Kananyan2311/Rubble-Rover/docsu/dcc4e0d6-4336-4faa-92a5-f5ddd7daa5ca.jpg

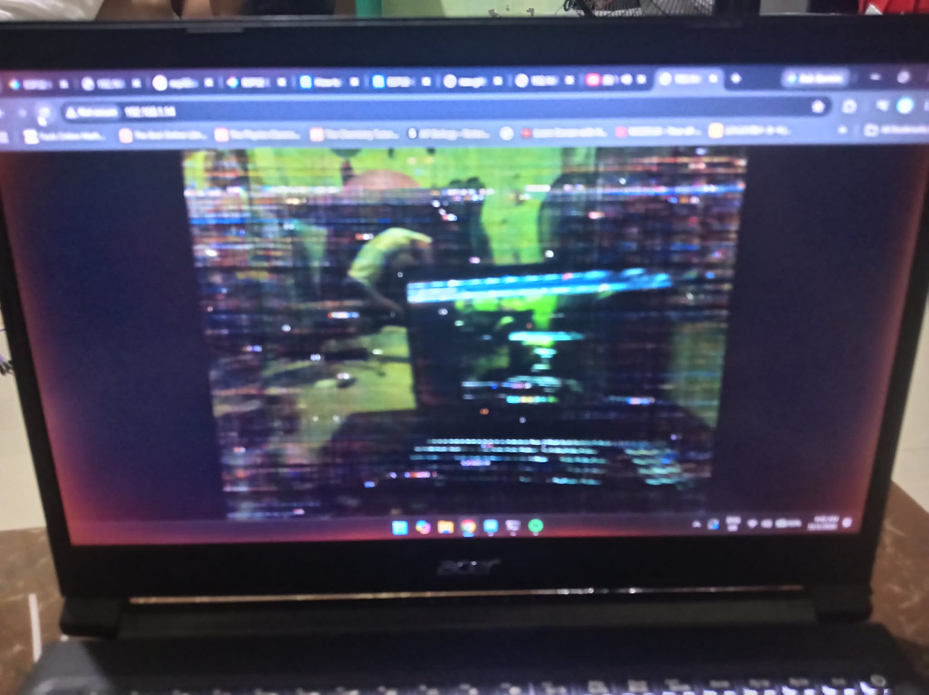
docsu/dcc4e0d6-4336-4faa-92a5-f5ddd7daa5ca.jpg
