Kananyan2311/Rubble-Rover/docsu/97220a8d-4763-489b-a496-95a2f28a7e50.jpg

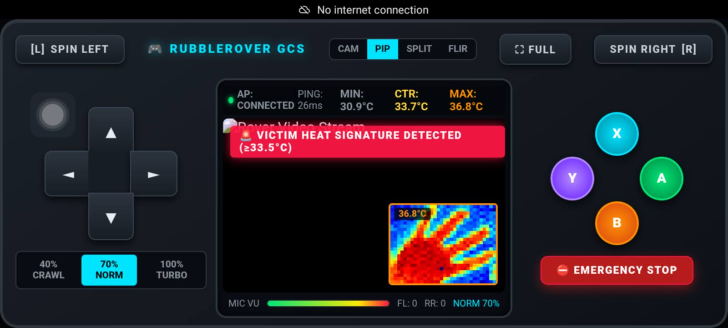
docsu/97220a8d-4763-489b-a496-95a2f28a7e50.jpg
