Kananyan2311/Rubble-Rover/docsu/8ca135fd-bad1-460d-b041-587a1cfcafc5.jpg

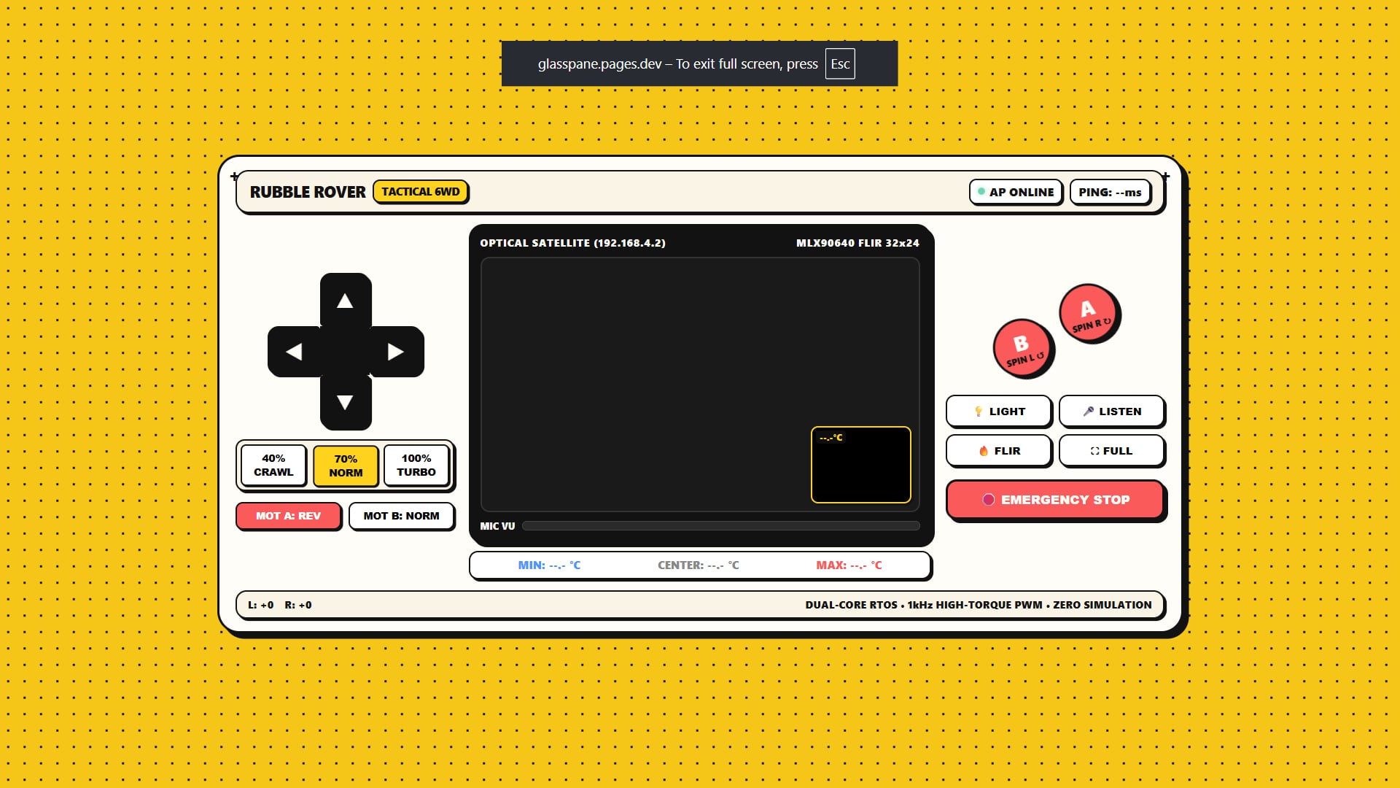
docsu/8ca135fd-bad1-460d-b041-587a1cfcafc5.jpg
