Kananyan2311/Rubble-Rover/docsu/85fc39a5-d4aa-493a-b52b-8984eef353a9.jpg

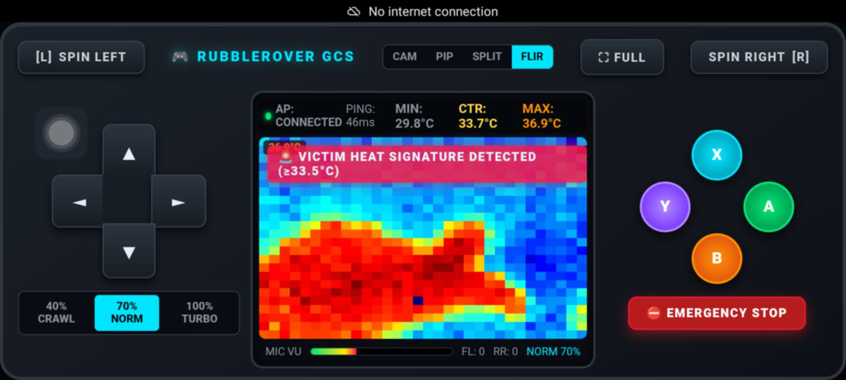
docsu/85fc39a5-d4aa-493a-b52b-8984eef353a9.jpg
