Kananyan2311/Rubble-Rover/docsu/70634dc6-3c7f-4a7d-961d-5ee7b60996f9.jpg

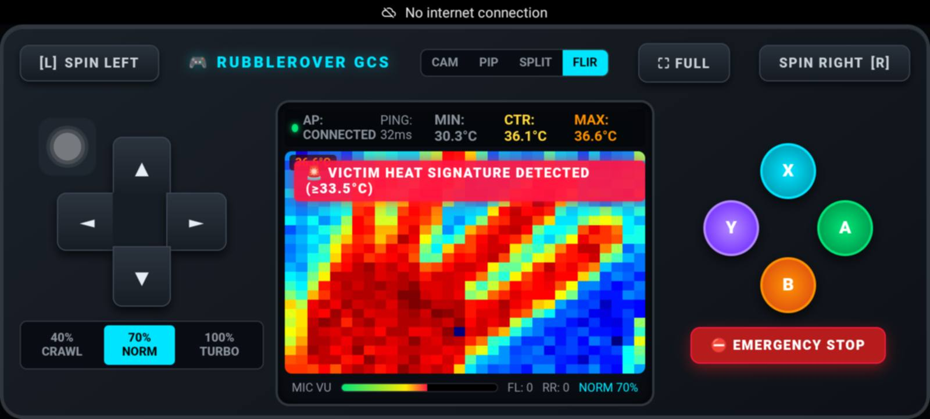
docsu/70634dc6-3c7f-4a7d-961d-5ee7b60996f9.jpg
