Kananyan2311/Rubble-Rover/docsu/801663b0-5177-4fae-9b44-58f6171b3113.jpg

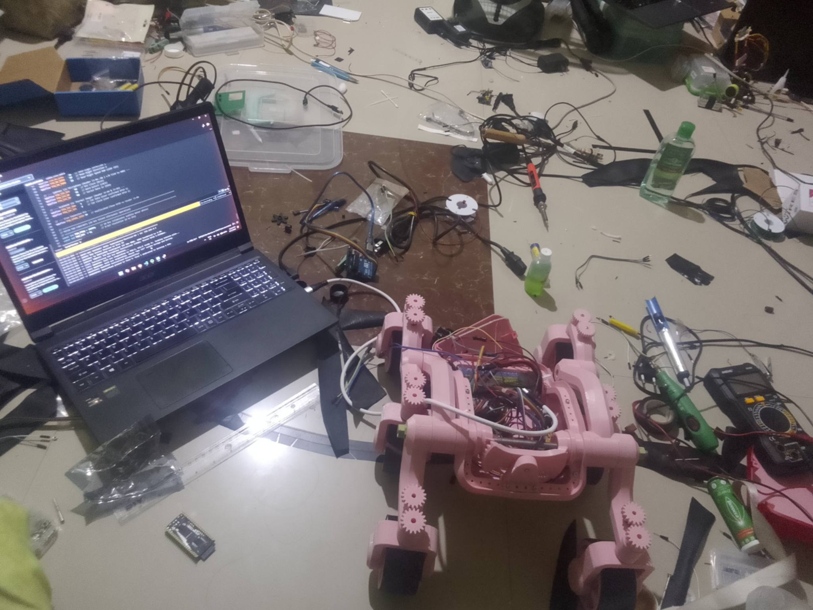
docsu/801663b0-5177-4fae-9b44-58f6171b3113.jpg
