Kananyan2311/Rubble-Rover/docsu/ec8b5fc5-6190-4d5c-a91b-74c8f4051346.jpg

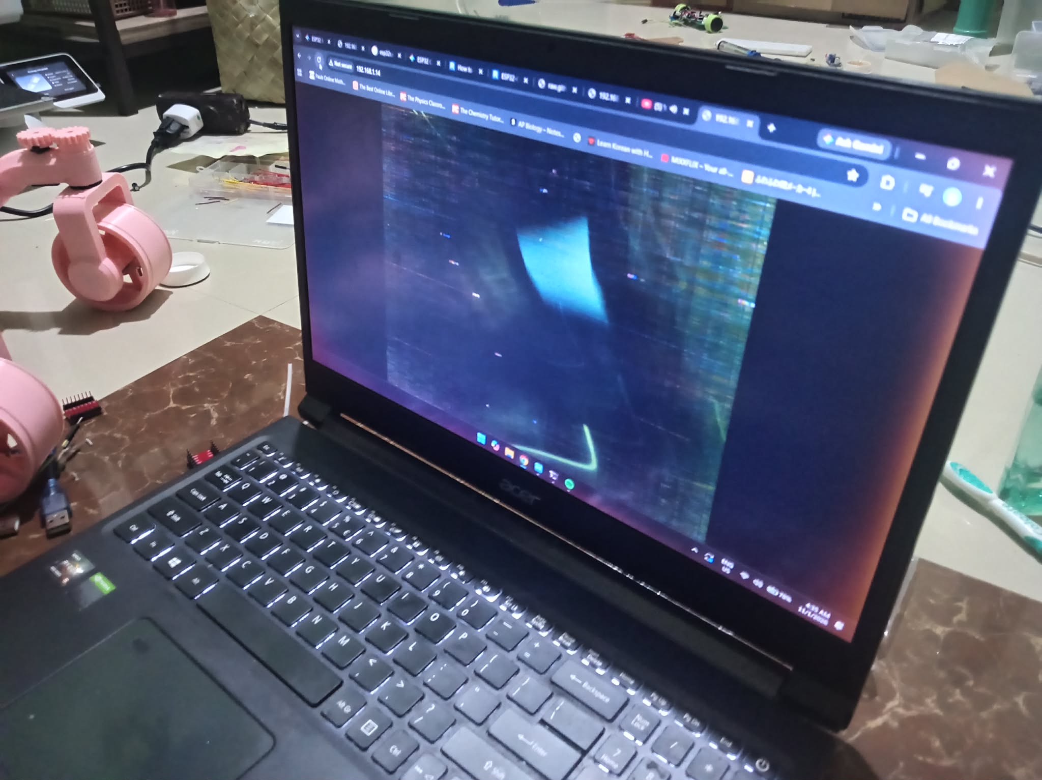
docsu/ec8b5fc5-6190-4d5c-a91b-74c8f4051346.jpg
