Kananyan2311/Rubble-Rover/docsu/f98f0c3a-2285-47ac-bcab-6023abbcfe9a.jpg

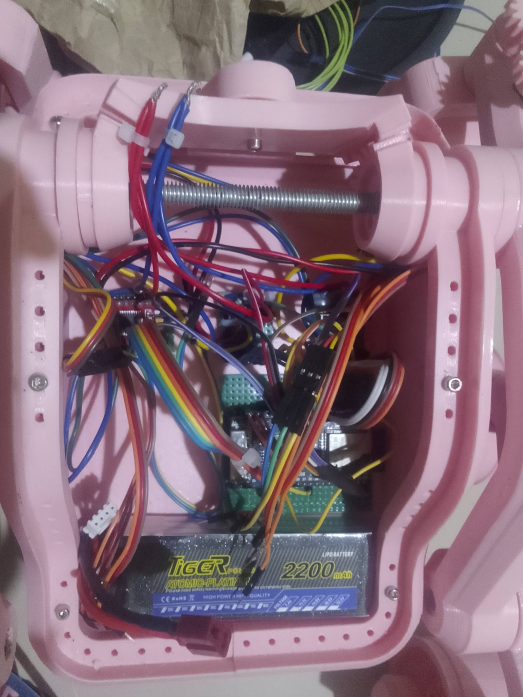
docsu/f98f0c3a-2285-47ac-bcab-6023abbcfe9a.jpg
