Kananyan2311/Rubble-Rover/ESP32_S3_ROVER_PINOUT.csv

Pin_Number | Header | ESP32_GPIO | Signal_Net_Name | Connected_Device | Device_Pin | Signal_Type | Description
J1-01 | J1 | 3V3 | 3V3_LOGIC | TB6612_#1_#2_#3 | VCC_AND_STBY | POWER | 3.3V Logic & STBY Hardwired (Always Active)
J1-02 | J1 | 3V3 | 3V3_SPARE | NC | NC | POWER | Spare 3.3V
J1-03 | J1 | EN | MCU_EN | RESET_BTN | EN | INPUT | Reset Pull-up
J1-04 | J1 | GPIO4 | M_ML_PWMA | TB6612_#2 | PWMA | OUTPUT_PWM | Middle-Left Motor Speed PWM (LEDC Ch2)
J1-05 | J1 | GPIO5 | M_ML_AIN1 | TB6612_#2 | AIN1 | OUTPUT_DIG | Middle-Left Motor Direction 1
J1-06 | J1 | GPIO6 | M_ML_AIN2 | TB6612_#2 | AIN2 | OUTPUT_DIG | Middle-Left Motor Direction 2
J1-07 | J1 | GPIO7 | M_MR_BIN1 | TB6612_#2 | BIN1 | OUTPUT_DIG | Middle-Right Motor Direction 1
J1-08 | J1 | GPIO15 | M_MR_BIN2 | TB6612_#2 | BIN2 | OUTPUT_DIG | Middle-Right Motor Direction 2
J1-09 | J1 | GPIO16 | M_MR_PWMB | TB6612_#2 | PWMB | OUTPUT_PWM | Middle-Right Motor Speed PWM (LEDC Ch3)
J1-10 | J1 | GPIO17 | M_FL_PWMA | TB6612_#1 | PWMA | OUTPUT_PWM | Front-Left Motor Speed PWM (LEDC Ch0)
J1-11 | J1 | GPIO18 | M_FL_AIN1 | TB6612_#1 | AIN1 | OUTPUT_DIG | Front-Left Motor Direction 1
J1-12 | J1 | GPIO8 | M_FL_AIN2 | TB6612_#1 | AIN2 | OUTPUT_DIG | Front-Left Motor Direction 2
J1-13 | J1 | GPIO3 | NC_STRAP | NC | NC | STRAPPING_PIN | JTAG Strap - DO NOT CONNECT (LEAVE NC)!
J1-14 | J1 | GPIO46 | NC_STRAP | NC | NC | STRAPPING_PIN | ROM Boot Log Strap - DO NOT CONNECT (LEAVE NC)!
J1-15 | J1 | GPIO9 | M_FR_BIN1 | TB6612_#1 | BIN1 | OUTPUT_DIG | Front-Right Motor Direction 1
J1-16 | J1 | GPIO10 | M_FR_BIN2 | TB6612_#1 | BIN2 | OUTPUT_DIG | Front-Right Motor Direction 2
J1-17 | J1 | GPIO11 | M_FR_PWMB | TB6612_#1 | PWMB | OUTPUT_PWM | Front-Right Motor Speed PWM (LEDC Ch1)
J1-18 | J1 | GPIO12 | M_RL_PWMA | TB6612_#3 | PWMA | OUTPUT_PWM | Rear-Left Motor Speed PWM (LEDC Ch4)
J1-19 | J1 | GPIO13 | M_RL_AIN1 | TB6612_#3 | AIN1 | OUTPUT_DIG | Rear-Left Motor Direction 1
J1-20 | J1 | GPIO14 | M_RL_AIN2 | TB6612_#3 | AIN2 | OUTPUT_DIG | Rear-Left Motor Direction 2
J1-21 | J1 | 5V | 5V_MCU | BUCK_CONV | 5V_OUT | POWER | 5V Main Supply Input to ESP32-S3 from Buck Converter
J1-22 | J1 | GND | GND | SYSTEM_GND | GND | POWER | Digital Ground Plane
J3-01 | J3 | GND | GND | SYSTEM_GND | GND | POWER | Digital Ground Plane
J3-02 | J3 | GPIO43 | UART0_TXD | DEBUG_HEADER | TXD | OUTPUT_DIG | UART0 Serial Debug TX - Keep Free
J3-03 | J3 | GPIO44 | UART0_RXD | DEBUG_HEADER | RXD | INPUT_DIG | UART0 Serial Debug RX - Keep Free
J3-04 | J3 | GPIO1 | I2C_THERMAL_SCL | MLX90640 | SCL | OUTPUT_DIG | MLX90640 I2C Clock (with 4.7k Pull-up)
J3-05 | J3 | GPIO2 | I2C_THERMAL_SDA | MLX90640 | SDA | BIDIRECTIONAL | MLX90640 I2C Data (with 4.7k Pull-up)
J3-06 | J3 | GPIO42 | I2S_MIC_SCK | INMP441 | SCK | OUTPUT_DIG | INMP441 I2S Bit Clock (BCLK) [Contiguous Bus]
J3-07 | J3 | GPIO41 | I2S_MIC_WS | INMP441 | WS | OUTPUT_DIG | INMP441 I2S Word Select (LRCK) [Contiguous Bus]
J3-08 | J3 | GPIO40 | I2S_MIC_SD | INMP441 | SD | INPUT_DIG | INMP441 I2S Serial Data Out (DIN) [Contiguous Bus]
J3-09 | J3 | GPIO39 | SPARE_IO39 | AUX_HEADER | SPARE | BIDIRECTIONAL | Clean Expansion GPIO (Unused / Spare)
J3-10 | J3 | GPIO38 | M_RR_BIN1 | TB6612_#3 | BIN1 | OUTPUT_DIG | Rear-Right Motor Direction 1
J3-11 | J3 | GPIO37 | NC_PSRAM | NC | NC | OCTAL_PSRAM | Octal PSRAM Line - DO NOT CONNECT (LEAVE NC)!
J3-12 | J3 | GPIO36 | NC_PSRAM | NC | NC | OCTAL_PSRAM | Octal PSRAM Line - DO NOT CONNECT (LEAVE NC)!
J3-13 | J3 | GPIO35 | NC_PSRAM | NC | NC | OCTAL_PSRAM | Octal PSRAM Line - DO NOT CONNECT (LEAVE NC)!
J3-14 | J3 | GPIO0 | NC_STRAP | NC | NC | STRAPPING_PIN | Boot Mode Strap / Button - DO NOT CONNECT (LEAVE NC)!
J3-15 | J3 | GPIO45 | NC_STRAP | NC | NC | STRAPPING_PIN | VDD_SPI Strap - DO NOT CONNECT (LEAVE NC)!
J3-16 | J3 | GPIO48 | NC_WS2812 | NC | NC | RGB_LED | DevKitC v1.0 Onboard WS2812 DIN - LEAVE UNCONNECTED (NC)
J3-17 | J3 | GPIO47 | M_RR_BIN2 | TB6612_#3 | BIN2 | OUTPUT_DIG | Rear-Right Motor Direction 2
J3-18 | J3 | GPIO21 | M_RR_PWMB | TB6612_#3 | PWMB | OUTPUT_PWM | Rear-Right Motor Speed PWM (LEDC Ch5)
J3-19 | J3 | GPIO20 | USB_DP | USB_HEADER | D+ | USB | Native USB D+ - Keep Free
J3-20 | J3 | GPIO19 | USB_DM | USB_HEADER | D- | USB | Native USB D- - Keep Free
J3-21 | J3 | GND | GND | SYSTEM_GND | GND | POWER | Digital Ground Plane
J3-22 | J3 | GND | GND | SYSTEM_GND | GND | POWER | Digital Ground Plane
CAM-01 | CAM_P1 | 5V | 5V_CAM | BUCK_CONV | 5V_OUT | POWER | 5V Main Supply Input to ESP32-CAM
CAM-02 | CAM_P1 | GND | GND | SYSTEM_GND | GND | POWER | Common Ground
CAM-03 | CAM_P1 | GPIO12 | NC_CAM | NC | NC | NC | Free - Leave Unconnected
CAM-04 | CAM_P1 | GPIO13 | NC_CAM | NC | NC | NC | Free - Leave Unconnected
CAM-05 | CAM_P1 | GPIO15 | NC_CAM | NC | NC | NC | Free - Leave Unconnected
CAM-06 | CAM_P1 | GPIO14 | NC_CAM | NC | NC | NC | Free - Leave Unconnected
CAM-07 | CAM_P1 | GPIO2 | NC_CAM | NC | NC | NC | Free - Leave Unconnected
CAM-08 | CAM_P1 | GPIO4 | FLASH_LED | ONBOARD_LED | GATE | OUTPUT_DIG | High-Power Flash Searchlight
CAM-09 | CAM_P2 | 3V3 | 3V3_CAM | NC | NC | POWER | 3.3V Output (Not Needed)
CAM-10 | CAM_P2 | GND | GND | SYSTEM_GND | GND | POWER | Common Ground
CAM-11 | CAM_P2 | GPIO0 | BOOT_BTN | JUMPER | GND | INPUT | Connect to GND only when flashing code
CAM-12 | CAM_P2 | GPIO16 | PSRAM_CS | ONBOARD_PSRAM | CS | RESERVED | Hardwired to external PSRAM chip - DO NOT USE
CAM-13 | CAM_P2 | GPIO3 | UART0_RX | SERIAL_DEBUG | RX | INPUT_DIG | UART0 RX for Flashing & Serial Monitor
CAM-14 | CAM_P2 | GPIO1 | UART0_TX | SERIAL_DEBUG | TX | OUTPUT_DIG | UART0 TX for Flashing & Serial Monitor
CAM-15 | CAM_P2 | GND | GND | SYSTEM_GND | GND | POWER | Common Ground
CAM-16 | CAM_P2 | 5V | 5V_IN | BUCK_CONV | 5V_OUT | POWER | Alternate 5V Input
