Kananyan2311/Rubble-Rover/CAPSTONE_PANEL_QA.md

<div align="center">

# 🎓 RUBBLE ROVER — CAPSTONE DEFENSE PANEL Q&A GUIDE
### **30 Comprehensive Technical, Architectural & Operational Questions & Answers**
*Prepared for Oral Defense, Technical Panel Interrogation & Live Prototype Demonstration*






</div>

---

## 🗂️ Clickable Project Document Hub

<table>
  <tr>
    <td align="center" width="25%">
      <a href="README.md">
        
      </a>
      <br />
      <sub><b>System Overview & Setup</b></sub>
    </td>
    <td align="center" width="25%">
      <a href="TROUBLESHOOTING.md">
        
      </a>
      <br />
      <sub><b>21 Serial Error Decoders</b></sub>
    </td>
    <td align="center" width="25%">
      <a href="RubbleRover_S3_MotorController/RubbleRover_S3_MotorController.ino">
        
      </a>
      <br />
      <sub><b>Direct AP Mode (<code>192.168.4.1</code>)</b></sub>
    </td>
    <td align="center" width="25%">
      <a href="Firmware_v2_Router_And_AP/RubbleRover_S3_MotorController_v2/RubbleRover_S3_MotorController_v2.ino">
        
      </a>
      <br />
      <sub><b>Router + AP Edition</b></sub>
    </td>
  </tr>
</table>

---

## 🧭 Quick Jump to Defense Category *(Click Any Badge)*

<div align="center">








</div>

---

> [!TIP]
> **Golden Rule for Capstone Defense:** Always answer in 3 parts: **(1) Direct Answer**, **(2) Engineering Reason / Trade-off**, and **(3) Exact Implementation Detail** (mention specific GPIO pins, frequencies, or thresholds).

---

## 🚨 Category 1: Project Rationale, Problem Statement & Architecture (Q1 – Q5)

### 🔴 Q1: What specific problem in post-earthquake search and rescue (SAR) does Rubble Rover solve, and why not use drones (UAVs) or K9 search dogs instead?
* **🎯 Why the Panel Asks This:** To test whether your project has a justified real-world niche compared to existing SAR solutions.
* **✅ Best Defense Answer:**
  > "During the critical **Golden 72 Hours** after a structural collapse, secondary aftershocks, toxic gas leaks, and narrow void spaces ($<30\text{ cm}$ high) make entry fatal for human rescuers. While aerial drones (UAVs) excel at overhead mapping, their propellers cannot fly inside tight subterranean rubble voids, and rotor downwash kicks up dense concrete dust that blinds cameras. K9 search dogs suffer from exhaustion, paws cut by shattered glass/rebar, and cannot transmit visual or thermal telemetry back to engineers. **Rubble Rover** bridges this gap as a compact, low-profile 6WD ground reconnaissance rover that crawls directly into dark void spaces to stream live **OV2640 optical video**, **MLX90640 $32\times24$ thermal heatmaps**, and **INMP441 digital audio** before risking human entry."

---

### 🔴 Q2: Why did you choose a standalone Wi-Fi Access Point (AP) architecture instead of Cloud IoT (Blynk, Firebase, AWS) or cellular 4G/LTE?
* **🎯 Why the Panel Asks This:** Many student IoT projects fail in real disaster scenarios because they rely on cloud servers or home routers.
* **✅ Best Defense Answer:**
  > "In a real magnitude $7.0+$ earthquake, cell towers are toppled, fiber optic lines are severed, and commercial power grids collapse—meaning **Cloud IoT platforms like Blynk or Firebase become 100% unusable**. Furthermore, cloud round-trip latency ($200\text{ ms}–800\text{ ms}$) is dangerous when driving a rover near unstable debris. Therefore, in **Edition 1**, the ESP32-S3 broadcasts its own self-contained Wi-Fi SoftAP (`RubbleRover-Tactical-AP` at `192.168.4.1`) with the entire Ground Control Station WebApp stored in internal Flash (`PROGMEM`). We also developed **Edition 2 (`WIFI_AP_STA`)**, which allows the rover and camera to join an emergency field router/mesh while simultaneously keeping their local APs active as a fail-safe."

---

### 🔴 Q3: Why did you design a Dual-MCU architecture (ESP32-S3 Master + ESP32-CAM Video Satellite) instead of running everything on a single microcontroller or a Raspberry Pi?
* **🎯 Why the Panel Asks This:** To evaluate your hardware partitioning, cost efficiency, and bus-contention analysis.
* **✅ Best Defense Answer:**
  > "We chose a **Dual-MCU distributed architecture** for three engineering reasons:
  > 1. **Pin & DMA Isolation:** The OV2640 camera requires 14 high-speed parallel DVP pins plus continuous DMA transfers. Running camera DMA, 18 motor pins, I2S audio DMA, and 8Hz I2C thermal polling on a single chip causes severe GPIO exhaustion and frame-buffer DMA contention.
  > 2. **Power & Thermal Efficiency vs. Raspberry Pi:** A Raspberry Pi 4/5 draws $1.5\text{ A}–3.0\text{ A}$ continuously, takes $30–45\text{ seconds}$ to boot Linux, and risks SD card corruption on sudden power loss. Our dual ESP32 system boots in **$<300\text{ ms}$**, consumes a fraction of the battery power, and costs under $\$15$ total in silicon.
  > 3. **Modular Fault Tolerance:** In Edition 2, even if one node's link is obstructed, the Motor/Sensor Hub (`192.168.4.1`) and Camera Hub (`192.168.5.1`) operate independently."

---

### 🔴 Q4: What is the difference between your Firmware Edition 1 (Direct AP) and Firmware Edition 2 (Router + AP Mode), and when would first responders use each?
* **🎯 Why the Panel Asks This:** You included two firmware folders in the repository; panelists will ask why both exist.
* **✅ Best Defense Answer:**
  > "**Edition 1 (`RubbleRover_S3_MotorController`)** is optimized for **Rapid Single-Operator Deployment**: the ESP32-S3 hosts the AP (`192.168.4.1`), and the ESP32-CAM automatically associates on Channel 1 with a static IP (`192.168.4.2`) in under $300\text{ ms}$.
  > **Edition 2 (`Firmware_v2_Router_And_AP`)** is designed for **Multi-Responder Command Post Operations**: both the ESP32-S3 and ESP32-CAM run in `WIFI_AP_STA` dual mode. They connect to a high-power portable field router so multiple rescue tablets can monitor the rover and camera simultaneously at extended range, while still broadcasting `RubbleRover-Tactical-AP` (`192.168.4.1`) and `RubbleRover-CAM-AP` (`192.168.5.1`) as direct fallback networks."

---

### 🔴 Q5: How does Rubble Rover ensure zero software installation for first responders in the field?
* **🎯 Why the Panel Asks This:** Usability under emergency stress is a core evaluation metric.
* **✅ Best Defense Answer:**
  > "First responders carry varied devices—iOS iPhones, Android tablets, or Windows laptops—and cannot download custom APKs when there is no internet. By embedding the entire **Neo-Brutalist GameBoy Ground Control Station (`RubbleRover_WebApp.html`)** directly into the ESP32-S3's flash memory (`PROGMEM`), any device with a standard web browser simply connects to the Wi-Fi network and opens `http://192.168.4.1`. It renders natively with zero external CDN dependencies, zero fonts to download, and full multi-touch support."

---

## ⚡ Category 2: Hardware Design, Silicon Pinout & Power Engineering (Q6 – Q10)

### 🟡 Q6: How did you allocate 23 GPIOs on the ESP32-S3 for 3x TB6612FNG drivers, MLX90640, and INMP441 without triggering hardware strapping traps or Octal PSRAM conflicts?
* **🎯 Why the Panel Asks This:** The ESP32-S3 has strict silicon restrictions that cause bootloops if violated.
* **✅ Best Defense Answer:**
  > "We conducted a strict silicon audit across all 45 ESP32-S3 GPIOs:
  > 1. **Strapping Pins Isolated:** We strictly avoided `GPIO 0` (Boot mode), `GPIO 3` (JTAG), `GPIO 45` ($V_{\text{DD\_SPI}}$ flash voltage), and `GPIO 46` (ROM log/boot trap).
  > 2. **Octal Flash/PSRAM Pins Isolated:** We completely avoided `GPIO 33, 34, 35, 36, 37`.
  > 3. **USB & UART0 Preserved:** We kept `GPIO 19, 20` (Native USB D-/D+) and `GPIO 43, 44` (UART0) untouched so programming and Serial debugging never conflict with motors.
  > 4. **Clean Physical Grouping:** Left-header J1 pins (`GPIO 4–18`) drive the Front, Middle, and Rear-Left motor channels; Right-header J3 pins (`GPIO 42, 41, 40`) form a contiguous 3-pin I2S bus for the INMP441, and `GPIO 1, 2` form the contiguous I2C bus for the MLX90640."

---

### 🟡 Q7: Why did you choose the TB6612FNG MOSFET H-Bridge motor driver over the traditional L298N driver?
* **🎯 Why the Panel Asks This:** Every electronics panel asks why you chose your specific motor driver IC.
* **✅ Best Defense Answer:**
  > "The legacy **L298N** uses bipolar Darcy/BJT transistors, which suffer a massive **$2.0\text{ V}–4.0\text{ V}$ internal voltage drop**, wasting battery energy as heat and requiring bulky heatsinks. In contrast, the **TB6612FNG** uses low-on-resistance **LD-MOSFETs** ($\text{R}_{\text{DS(on)}} \approx 0.5\,\Omega$), dropping less than $0.2\text{ V}$. This delivers nearly $100\%$ of our battery voltage directly to the 6 DC gearmotors for maximum climbing torque over rubble, runs cool without heatsinks, and supports $1.2\text{ A}$ continuous ($3.2\text{ A}$ peak) per channel."

---

### 🟡 Q8: How did you minimize GPIO usage on the TB6612FNG (`STBY` pin) and the INMP441 (`L/R` pin), and is hardwiring `STBY` to 3.3V safe during boot?
* **🎯 Why the Panel Asks This:** To test your understanding of pull-down resistors and hardware pin optimization.
* **✅ Best Defense Answer:**
  > "Controlling 3x TB6612FNG drivers with individual `STBY` pins plus an `L/R` pin for the mic would have wasted 4 extra GPIOs.
  > 1. **TB6612 `STBY` Tied to `3.3V`:** According to the Toshiba TB6612FNG datasheet, all input pins (`AIN1, AIN2, BIN1, BIN2, PWMA, PWMB`) have built-in **$200\text{ k}\Omega$ internal pull-down resistors**. During the few milliseconds while ESP32-S3 GPIOs are High-Z at reset, the TB6612 inputs are automatically pulled `LOW`, keeping all motors safely in Coast/Stop mode even with `STBY` tied to `3.3V`.
  > 2. **INMP441 `L/R` Tied to `GND`:** Tying `L/R` permanently to `GND` configures the microphone to transmit on the Left I2S time slot, saving 1 GPIO."

---

### 🟡 Q9: Why do 6WD DC gearmotors cause microcontroller brownout resets when starting, and how does your power architecture prevent this?
* **🎯 Why the Panel Asks This:** Power integrity is the #1 hardware failure point in mobile robotics.
* **✅ Best Defense Answer:**
  > "When 6 DC motors start from a dead stop (stall condition) or rapidly reverse direction, their back-EMF is zero and they draw an **inrush current spike of $2.5\text{ A}–4.5\text{ A}$**. If the ESP32-S3 shares an unisolated power path, internal battery resistance causes voltage sag ($V = I \times R_{\text{internal}}$). If the ESP32's rail drops below **$2.8\text{ V}$** for even a few microseconds, the hardware Brownout Detector resets the CPU. We prevent this by separating the **`VM` Motor Power Domain** (fed directly from the battery with bulk $1000\,\mu\text{F}$ electrolytic decoupling capacitors) from the **`3.3V/5V` Logic Domain** (regulated via a dedicated step-down buck converter), connected only at a single star Common Ground (`GND`)."

---

### 🟡 Q10: Why did you select a 6-Wheel Drive (6WD) differential skid-steer chassis for post-earthquake rubble navigation?
* **🎯 Why the Panel Asks This:** Mechanical justification of the locomotion system.
* **✅ Best Defense Answer:**
  > "Unlike 2WD or 4WD Ackermann (car-like) steering—which requires a wide turning radius and gets high-centered when one wheel drops into a crack—a **6WD differential skid-steer layout** provides three major advantages:
  > 1. **Redundant Traction:** Even if 2 wheels are suspended over a gap in the rubble, the remaining 4 wheels maintain ground contact and propulsion.
  > 2. **Zero-Radius Tank Pivoting:** By driving the Left bank (`FL, ML, RL`) and Right bank (`FR, MR, RR`) in opposite directions, the rover can spin $360^\circ$ in place inside a narrow corridor.
  > 3. **Mechanical Simplicity:** Eliminating steering servo linkages removes fragile mechanical parts that easily snap under debris impact."

---

## 🛞 Category 3: Motor Control Physics, TB6612FNG & Kinematics (Q11 – Q15)

### 🟢 Q11: During testing, why were the motors initially stiff and hard to turn by hand when powered on, and how did you solve the TB6612 Dynamic Short-Brake issue?
* **🎯 Why the Panel Asks This:** This demonstrates real-world hardware debugging and deep datasheet comprehension.
* **✅ Best Defense Answer:**
  > "When we initially tested the rover, the wheels resisted manual rotation when powered on. By analyzing the **TB6612FNG truth table**, we discovered that whenever direction pins are complementary (`IN1 != IN2`) while `PWM = LOW (0V)`—or when `IN1 = HIGH` and `IN2 = HIGH`—the TB6612 enters **Active Short-Brake Mode**, shorting the motor coil terminals together to `GND`. Any attempt to rotate the wheel by hand generates back-EMF current that opposes motion (Lenz's Law). We solved this by rewriting `stopMotors()` to drive all 18 pins (`IN1 = LOW, IN2 = LOW, PWM = LOW`), placing all 3 H-bridges into **High-Z Neutral Coast Mode** so the wheels spin freely when stopped."

---

### 🟢 Q12: Why did you implement direct digital high-torque drive (`digitalWrite(HIGH)` for speeds $\ge 180$) instead of standard LEDC PWM on the ESP32-S3?
* **🎯 Why the Panel Asks This:** Panelists may inspect `setMotorPin()` in your `.ino` code and ask why it uses `digitalWrite(HIGH)`.
* **✅ Best Defense Answer:**
  > "In ESP32 Arduino Core 3.x, calling `pinMode(pin, OUTPUT)` attaches the pin to the GPIO peripheral bus, and subsequent `analogWrite()` calls across 6 simultaneous channels can encounter LEDC timer reallocation or peripheral manager detachment issues, leaving the `PWM` pin at `0V` (which traps the TB6612 in Short-Brake mode). Furthermore, DC gearmotors on heavy 6WD chassis require high breakaway voltage to overcome static gearbox friction. By using `digitalWrite(pwmPin, HIGH)` for our primary driving gears ($\ge 180$), we guarantee a rock-solid **$3.3\text{ V}$ gate drive ($100\%$ duty cycle)** to the TB6612 MOSFETs with zero timer stalls and maximum climbing torque."

---

### 🟢 Q13: Why is Motor Bank A (`polarityA = -1`) inverted in software by default compared to Motor Bank B (`polarityB = +1`)?
* **🎯 Why the Panel Asks This:** To see if you understand physical motor mounting symmetry on a differential chassis.
* **✅ Best Defense Answer:**
  > "On a 6WD chassis, the Left-bank motors (`FL, ML, RL` wired to TB6612 Channel A) and Right-bank motors (`FR, MR, RR` wired to TB6612 Channel B) are mounted mirrored $180^\circ$ opposite each other. If identical `HIGH/LOW` logic is applied to both banks, one side rotates clockwise and the other counter-clockwise, causing the robot to spin in place instead of moving forward. By setting `polarityA = -1` in firmware (driving `AIN1=LOW, AIN2=HIGH` for forward) and providing instant `MOT A / MOT B` polarity toggle buttons on the WebApp HUD, all 6 wheels roll forward in unison without needing to desolder motor leads."

---

### 🟢 Q14: How does your rover differentiate between Arc Steering (D-Pad Left/Right while moving) and Point-Turn Tank Pivoting (GameBoy Buttons A & B)?
* **🎯 Why the Panel Asks This:** To test your kinematic control mapping.
* **✅ Best Defense Answer:**
  > "We separated steering into two intuitive modes on the GameBoy console:
  > 1. **Point-Turn Tank Pivot (`spinLeft` / `spinRight` via Buttons B & A):** Drives one bank forward at full speed and the opposite bank in reverse (`Left = -Speed, Right = +Speed`), rotating the rover $360^\circ$ around its geometric center.
  > 2. **Arc Steering (`steerForwardLeft` / `steerForwardRight`):** Keeps the outer wheel bank driving while coasting the inner wheel bank (`High-Z`), allowing smooth directional corrections while advancing through corridors."

---

### 🟢 Q15: What happens if the operator's smartphone loses Wi-Fi connection or the browser crashes while the rover is driving at full speed?
* **🎯 Why the Panel Asks This:** Safety fail-safes are mandatory in robotics defenses.
* **✅ Best Defense Answer:**
  > "We implemented a **Hardware-Timed Watchdog Fail-Safe (`WATCHDOG_TIMEOUT_MS = 1000`)** inside `loop()` on Core 1. Every incoming `/control` packet updates `lastControlTime = millis()`. The WebApp heartbeat sends keep-alive packets every $75\text{ ms}$ while driving. If signal is lost for more than **$1000\text{ ms}$ (1 second)**, the ESP32-S3 automatically triggers `stopMotors()`, clamping all 18 motor pins to `LOW` and printing `[WATCHDOG] Failsafe timeout! Stopping motors.` to prevent a runaway rover."

---

## 🔥 Category 4: Thermal Imaging (MLX90640) & Victim Detection (Q16 – Q20)

### 🔵 Q16: Why did you choose the MLX90640 ($32 \times 24$ Far-Infrared array) over a single-point IR thermometer (MLX90614) or an AMG8833 ($8 \times 8$) sensor?
* **🎯 Why the Panel Asks This:** Sensor selection justification and resolution comparison.
* **✅ Best Defense Answer:**
  > "A single-point sensor like the **MLX90614** only measures 1 pixel (a single spot average), making it impossible to distinguish a human limb from background rubble. The **AMG8833** only offers $8 \times 8 = 64\text{ pixels}$ and a short range ($\sim 5\text{ m}$). The **Melexis MLX90640** provides a **$32 \times 24$ thermopile array ($768\text{ independent temperature pixels}$)**—$12\times$ the resolution of the AMG8833—with an operating range of $-40^\circ\text{C}$ to $+300^\circ\text{C}$ and a wide $55^\circ \times 35^\circ$ field of view, enabling true spatial heat-signature imaging."

---

### 🔵 Q17: How did you determine the $\ge 33.5^\circ\text{C}$ threshold for the automatic Survivor Heat Signature Alert?
* **🎯 Why the Panel Asks This:** Panelists always ask where a numeric threshold came from.
* **✅ Best Defense Answer:**
  > "While internal human core temperature is $37.0^\circ\text{C}$, exposed skin surface temperature (face, hands, or limbs visible through rubble dust) combined with radiative attenuation over a $1\text{ m}–3\text{ m}$ air gap typically measures between **$33.5^\circ\text{C}$ and $36.8^\circ\text{C}$**, whereas ambient concrete rubble indoors is typically $20^\circ\text{C}–28^\circ\text{C}$. Setting the threshold at **$\ge 33.5^\circ\text{C}$** reliably triggers the flashing red **`SURVIVOR HEAT SIGNATURE DETECTED`** HUD banner on exposed human skin while avoiding false alarms from ambient room surfaces."

---

### 🔵 Q18: How does your firmware prevent the rover from freezing at boot if the MLX90640 sensor is disconnected, loose, or has swapped SDA/SCL wires?
* **🎯 Why the Panel Asks This:** Demonstrates fault-tolerant embedded systems engineering.
* **✅ Best Defense Answer:**
  > "Standard Arduino I2C code often hangs indefinitely if a sensor is unplugged or if SDA/SCL wires are reversed. We engineered three layers of fault tolerance in `setupThermalSensor()` and `sensorTask()`:
  > 1. **50 ms Hardware Timeout:** We enforce `Wire.setTimeOut(50)` so a missing or shorted I2C bus never blocks the CPU.
  > 2. **Automatic Pin-Swap Recovery:** At boot, if `0x33` does not ACK on `SDA=GPIO 1, SCL=GPIO 2`, the firmware automatically tests `SDA=GPIO 2, SCL=GPIO 1` and remaps the pins in software if reversed.
  > 3. **Background Hot-Plug Auto-Probe:** If the sensor comes loose from vibration, the rover continues driving normally and probes `0x33` every 2 seconds on Core 0, automatically re-initializing the sensor the instant contact is restored."

---

### 🔵 Q19: How do you achieve a smooth visual FLIR thermal display on the web console from a $32 \times 24$ pixel sensor array?
* **🎯 Why the Panel Asks This:** Tests your understanding of client-side rendering and bandwidth optimization.
* **✅ Best Defense Answer:**
  > "Instead of rendering heavy images on the ESP32-S3 (which would waste CPU and Wi-Fi bandwidth), the ESP32-S3 transmits a lightweight JSON array of $768$ floating-point temperatures (`/thermal`), junto with `min`, `max`, and `center` crosshair readings. On the smartphone/laptop browser, our HTML5 `<canvas>` maps each temperature dynamically between `minT` and `maxT` using a **5-stop Ironbow/FLIR false-color gradient** (Deep Blue $\rightarrow$ Cyan $\rightarrow$ Green $\rightarrow$ Yellow $\rightarrow$ White-Hot Red) with CSS smooth interpolation."

---

### 🔵 Q20: Can the MLX90640 detect a survivor completely buried under thick solid concrete, or how is it used in void-space reconnaissance?
* **🎯 Why the Panel Asks This:** A classic "trick question" from physics-minded panelists to test if you know the limits of Far-Infrared (LWIR) radiation.
* **✅ Best Defense Answer:**
  > "Long-Wave Infrared ($8\,\mu\text{m}–14\,\mu\text{m}$) radiation cannot pass through solid concrete slabs. That is precisely why stationary thermal cameras outside a collapsed building fail, and **why a mobile rover is needed**! Rubble Rover crawls *inside* the structural void spaces beneath collapsed pancaked floors to establish line-of-sight with trapped survivors—detecting body heat in pitch-black darkness or through thin dust/smoke where optical cameras see nothing, while using the **INMP441 microphone** to detect acoustic tapping or voices through solid barriers."

---

## 🎙️ Category 5: Acoustic Tracking (INMP441), Video (OV2640) & Dual-Core RTOS (Q21 – Q25)

### 🟣 Q21: Why did you use an INMP441 digital I2S MEMS microphone instead of an analog microphone module (like MAX9814 or KY-038)?
* **🎯 Why the Panel Asks This:** To test your understanding of electromagnetic interference (EMI) and ADC noise on ESP32.
* **✅ Best Defense Answer:**
  > "Analog microphones output a millivolt-level analog signal that is highly susceptible to electromagnetic interference (EMI) from the 6 DC brush motors and the ESP32's $2.4\text{ GHz}$ Wi-Fi transmitter, resulting in loud buzzing noise. Furthermore, the ESP32's internal SAR ADC is notoriously non-linear. The **INMP441** has an onboard 24-bit $\Sigma\Delta$ ADC inside its shielded MEMS package and transmits pure digital audio over the **I2S bus (`SCK=42, WS=41, SD=40`)** via DMA, providing crystal-clear $16\text{ kHz}$ voice and tapping detection."

---

### 🟣 Q22: How does the ESP32-S3 dual-core FreeRTOS architecture prevent the 8Hz thermal polling and 16kHz audio sampling from delaying motor control commands?
* **🎯 Why the Panel Asks This:** Core architectural question on real-time responsiveness.
* **✅ Best Defense Answer:**
  > "The ESP32-S3 features dual Xtensa LX7 cores running at $240\text{ MHz}$. Using `xTaskCreatePinnedToCore()`, we pinned `sensorTask` strictly to **Core 0 (Application/Sensor Core)**, while keeping `loop()` (WebServer and Motor Control) on **Core 1**. Reading a $768$-pixel I2C frame from the MLX90640 takes $\sim 45\text{ ms}$ of bus time. Because that happens on Core 0 and copies data into a thread-safe buffer protected by a `portMUX_TYPE` spinlock (`thermalMux`), **Core 1 never waits for I2C or I2S**, executing `/control` motor commands in **$<2\text{ ms}$**."

---

### 🟣 Q23: How did you prevent the `/audio.wav` endpoint from blocking the HTTP web server on Core 1?
* **🎯 Why the Panel Asks This:** Streaming live audio on an single-threaded `WebServer` normally freezes all other HTTP endpoints.
* **✅ Best Defense Answer:**
  > "If `/audio.wav` used an infinite `while(true)` streaming loop on `WebServer(80)`, it would permanently occupy the HTTP server thread and block all `/control` motor packets. Instead, we implemented **Non-Blocking Fast WAV Slicing**: Core 0 continuously fills a static ring buffer (`audioSliceBuffer[4000]`) in the background and computes the real-time RMS loudness (`liveSoundLevel 0–100%`). When the browser requests `/audio.wav`, Core 1 prepends a 44-byte RIFF/WAVE header, bursts the pre-captured PCM slice in $<3\text{ ms}$, and closes the transaction immediately—zero server freezing!"

---

### 🟣 Q24: How did you optimize the ESP32-CAM (OV2640) to achieve sub-second Wi-Fi association and low-latency MJPEG streaming without frame lag buildup?
* **🎯 Why the Panel Asks This:** ESP32-CAM is famous for $3\text{ s}–5\text{ s}$ video lag if configured with default settings.
* **✅ Best Defense Answer:**
  > "We applied four specific optimizations in `RubbleRover_CAM_SurveillanceHub.ino`:
  > 1. **`CAMERA_GRAB_LATEST` Framebuffer Mode:** With `fb_count = 2` and `grab_mode = CAMERA_GRAB_LATEST`, the camera driver always discards stale buffered frames and transmits the newest frame, eliminating the classic multi-second video delay.
  > 2. **Modem Sleep Disabled:** `WiFi.setSleep(false)` prevents the ESP32 radio from entering power-saving sleep between beacons, doubling MJPEG frame rate stability.
  > 3. **Direct Channel-1 Static IP Association:** In Edition 1, pre-assigning static IP `192.168.4.2` and specifying RF Channel 1 (`WiFi.begin(SSID, PASS, 1)`) bypasses full 13-channel scanning and DHCP negotiation, connecting in **$<300\text{ ms}$**."

---

### 🟣 Q25: In Firmware Edition 2 (`v2`), why does the ESP32-CAM run two HTTP servers simultaneously (Port 80 and Port 81)?
* **🎯 Why the Panel Asks This:** Shows mastery of the ESP-IDF `esp_http_server` architecture.
* **✅ Best Defense Answer:**
  > "Each `httpd_handle_t` instance in `esp_http_server` processes requests sequentially on a single socket task. Because `/stream` is a continuous `multipart/x-mixed-replace` MJPEG loop, if `/light` (Searchlight) and `/status` shared the same server port while streaming, clicking the Searchlight button would hang waiting for the video stream to close! By running `camera_httpd` on **Port 80** (for the Web Console `/`, `/light`, `/status`, `/set_wifi`) and a second `stream_httpd` instance on **Port 81** (`:81/stream`), searchlight toggles respond instantaneously while high-FPS video streams uninterrupted."

---

## 🌐 Category 6: Network Scheduling, Testing, Limitations & Future Work (Q26 – Q30)

### 🩷 Q26: What is the "In-Flight Coalescing Control Scheduler" in your WebApp JavaScript, and why is it better than `setInterval()` polling for Wi-Fi robot control?
* **🎯 Why the Panel Asks This:** Evaluates your front-end/network systems engineering.
* **✅ Best Defense Answer:**
  > "Naive web robots use `setInterval(() => fetch('/control'), 50)`, which fires 20 HTTP requests per second blindly—even if the previous request hasn't returned yet. On an ESP32, this floods the TCP socket queue (`lwIP`), causing massive latency spikes (command queuing lag where the robot keeps moving for 3 seconds after you release the button). Our **In-Flight Coalescing Scheduler** tracks `inFlight = true/false`. It allows **at most 1 active HTTP request on the wire at a time**. If the user moves the D-pad while a packet is in flight, it sets `pendingDispatch = true` and coalesces the latest state, dispatching it the exact millisecond the previous ACK returns."

---

### 🩷 Q27: What is the effective wireless operating range of Rubble Rover inside collapsed structures, and what factors affect 2.4 GHz signal penetration?
* **🎯 Why the Panel Asks This:** Practical operational limits question.
* **✅ Best Defense Answer:**
  > "With `WiFi.setTxPower(WIFI_POWER_19_5dBm)` (maximum legal $+19.5\text{ dBm}$ output), Rubble Rover achieves **$40\text{ m}–60\text{ m}$ in line-of-sight corridors** and **$10\text{ m}–20\text{ m}$ through reinforced concrete rubble walls** (since $2.4\text{ GHz}$ has longer wavelength and better obstacle penetration than $5\text{ GHz}$). Furthermore, using **Firmware Edition 2 (`Router + AP Mode`)**, first responders can place a high-gain portable Wi-Fi router at the entrance of the collapsed structure to act as a high-power relay between the rover inside the rubble and command tablets outside."

---

### 🩷 Q28: How did you verify and test the reliability of each individual motor and sensor subsystem?
* **🎯 Why the Panel Asks This:** Panelists look for structured verification methodology.
* **✅ Best Defense Answer:**
  > "We built both hardware and software diagnostic tools directly into the system:
  > 1. **Built-In `/test_motors` Endpoint:** Calling `http://192.168.4.1/test_motors` executes `runMotorDiagnostic()`, which sequentially pulses `FL -> FR -> ML -> MR -> RL -> RR` for 1 second each while logging to Serial Monitor, allowing instant isolation of any loose wire or driver channel.
  > 2. **2.5-Second Serial Heartbeat:** Continuously reports connected client count, MLX90640 status, INMP441 status, live sound percentage, and IP addresses.
  > 3. **Automated 5-Cycle Verification Suite:** Verified zero GPIO collisions, High-Z coast initialization, and thermal threshold accuracy ($\ge 33.5^\circ\text{C}$)."

---

### 🩷 Q29: What are the current limitations of the Rubble Rover prototype?
* **🎯 Why the Panel Asks This:** Honesty and engineering self-awareness score high marks with capstone panels.
* **✅ Best Defense Answer:**
  > "Our current prototype has three main scope boundaries:
  > 1. **One-Way Acoustic Link:** The INMP441 provides clear rover-to-operator listening, but two-way voice (speaker on the rover) is not yet populated to conserve battery and GPIOs.
  > 2. **Non-Waterproof Enclosure:** The chassis is designed for dry rubble and indoor structural voids rather than flooded or submerged environments.
  > 3. **Line-of-Sight RF Attenuation:** Extreme multi-story underground collapses with thick rebar grids can attenuate $2.4\text{ GHz}$ Wi-Fi beyond $20\text{ meters}$ without an intermediate router relay."

---

### 🩷 Q30: If given additional funding or for future iterations, what upgrades would you implement to transition Rubble Rover into a field-certified rescue robot?
* **🎯 Why the Panel Asks This:** Standard closing capstone question on future recommendations.
* **✅ Best Defense Answer:**
  > "For Phase 2 development, we recommend four targeted upgrades:
  > 1. **Two-Way Tactical Intercom (MAX98357A I2S Amplifier):** Utilizing our spare pin `GPIO 39` (`PIN_SPARE_IO39`) to add an I2S speaker so rescuers can talk back to trapped survivors.
  > 2. **CO$_2$ & Combustible Gas Sensors (SCD40 / MQ-4):** Adding gas telemetry on the existing I2C bus (`GPIO 1, 2`) to warn rescuers of gas leaks or oxygen depletion—and detecting human respiration ($CO_2$ plumes) in rubble voids.
  > 3. **Sub-GHz LoRa / Tethered Ethernet Fallback:** Adding a $433\text{ MHz}/915\text{ MHz}$ control link or micro-tether for deep subterranean penetration.
  > 4. **IP65 Sealed Tracked/Rocker-Bogie Chassis:** Upgrading to an enclosed aluminum or carbon-fiber dustproof body."

---

<div align="center">





</div>
